gioguedes/sistema-tcc-completo/hardware/caixa/render/base.png

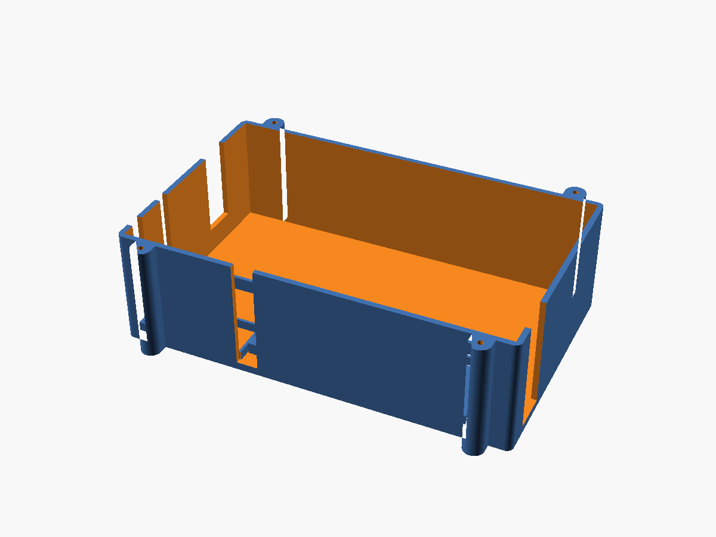
hardware/caixa/render/base.png
