gioguedes/sistema-tcc-completo/hardware/caixa/render/base_frente.png

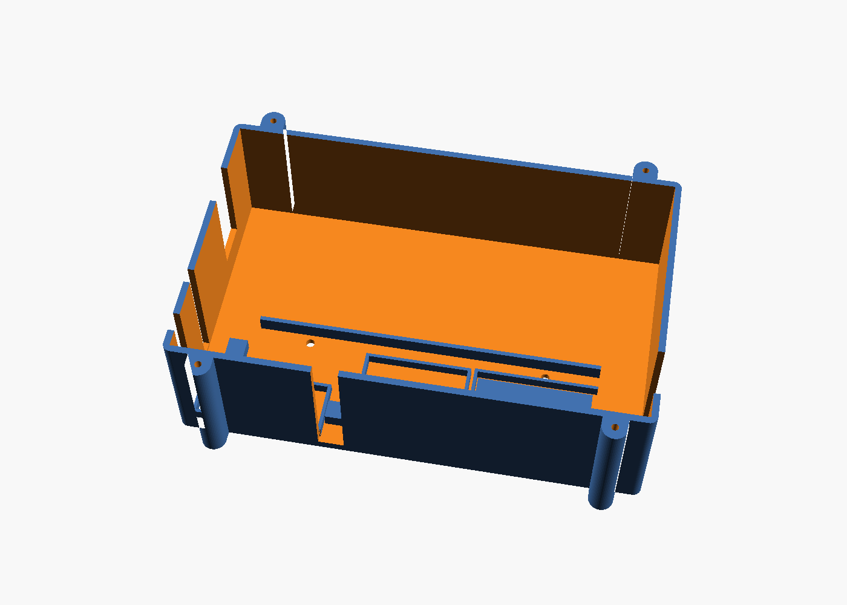
hardware/caixa/render/base_frente.png
