gioguedes/sistema-tcc-completo/hardware/caixa/render/gancho.png

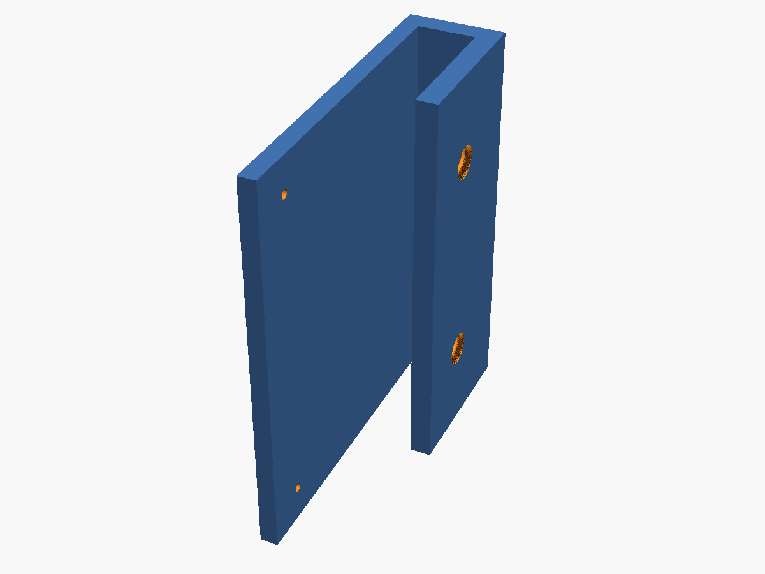
hardware/caixa/render/gancho.png
