gioguedes/sistema-tcc-completo/hardware/caixa/render/mesa_0-provas-opcional.png

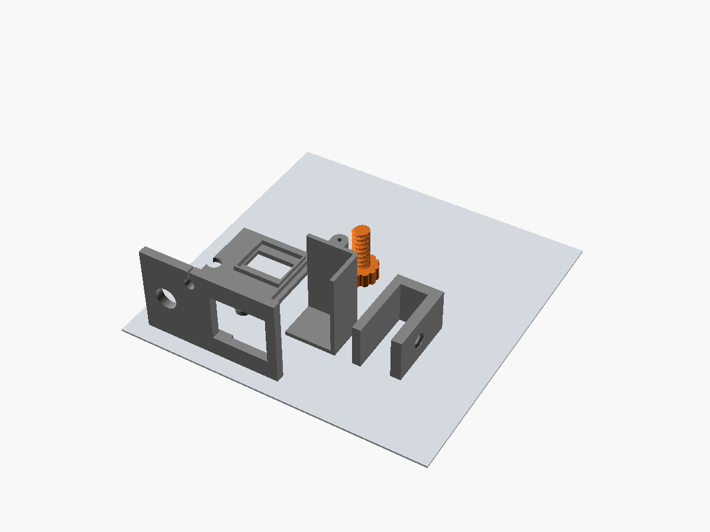
hardware/caixa/render/mesa_0-provas-opcional.png
