gioguedes/sistema-tcc-completo/hardware/caixa/render/mesa_1-base-e-parafusos.png

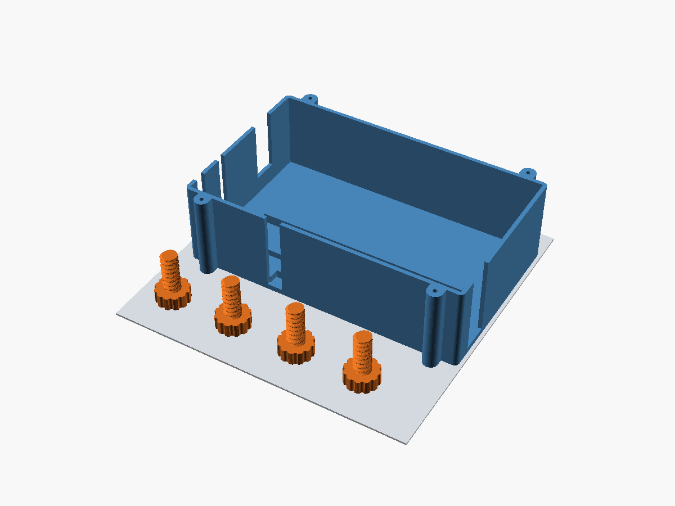
hardware/caixa/render/mesa_1-base-e-parafusos.png
