gioguedes/sistema-tcc-completo/hardware/caixa/render/mesa_2-gancho-e-suporte.png

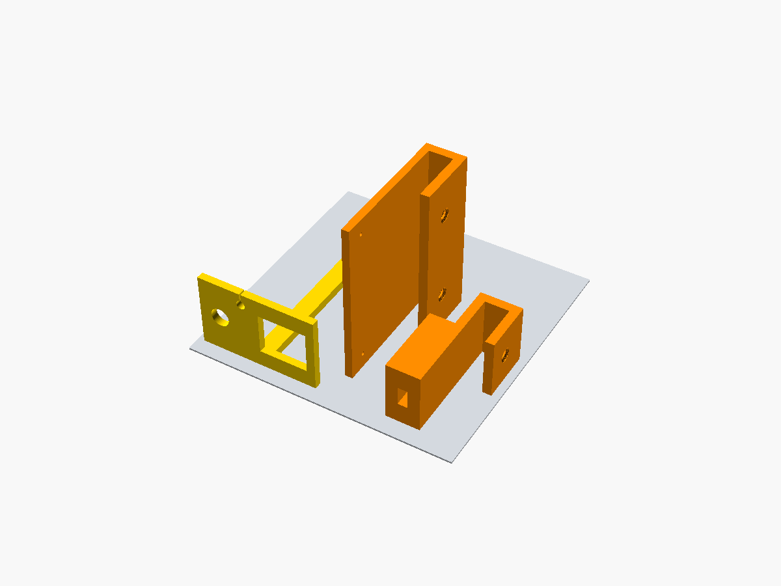
hardware/caixa/render/mesa_2-gancho-e-suporte.png
