gioguedes/sistema-tcc-completo/hardware/caixa/render/mesa_3-tampa.png

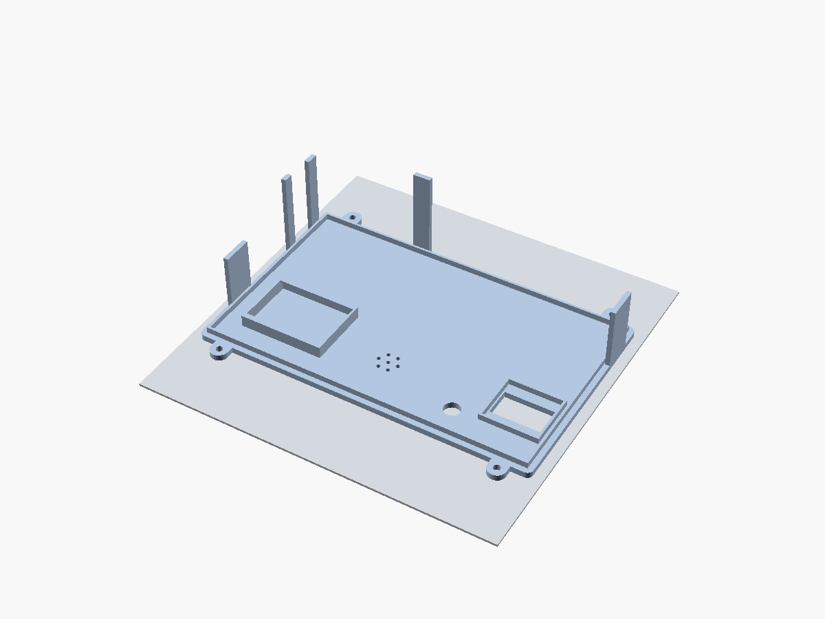
hardware/caixa/render/mesa_3-tampa.png
