gioguedes/sistema-tcc-completo/hardware/caixa/render/parafuso.png

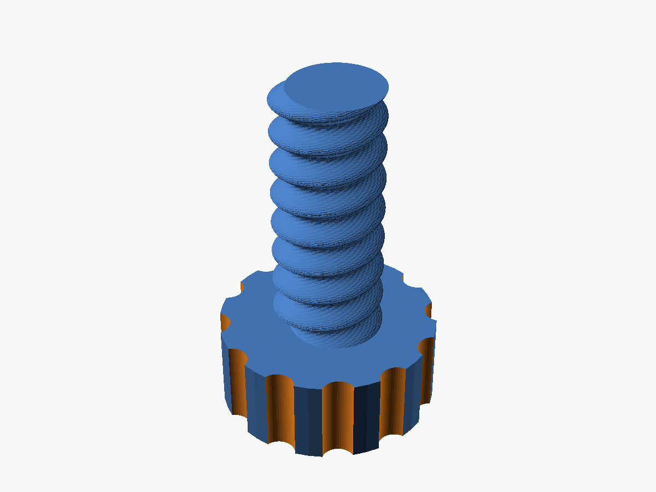
hardware/caixa/render/parafuso.png
