gioguedes/sistema-tcc-completo/hardware/caixa/render/prova_base.png

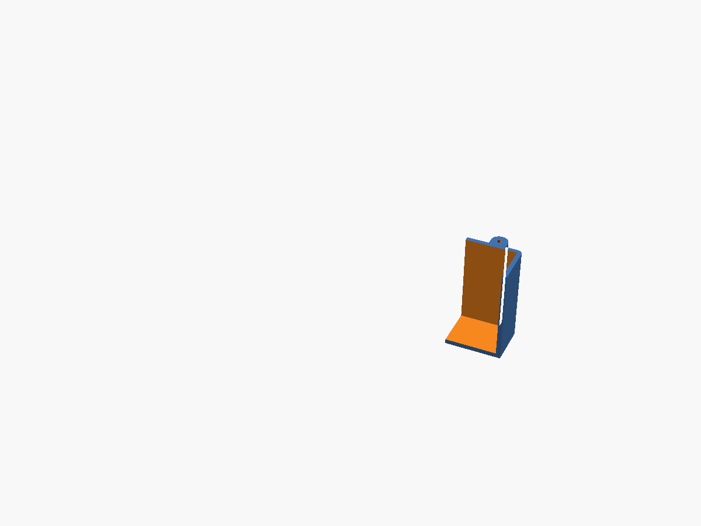
hardware/caixa/render/prova_base.png
