gioguedes/sistema-tcc-completo/hardware/caixa/render/prova_gancho.png

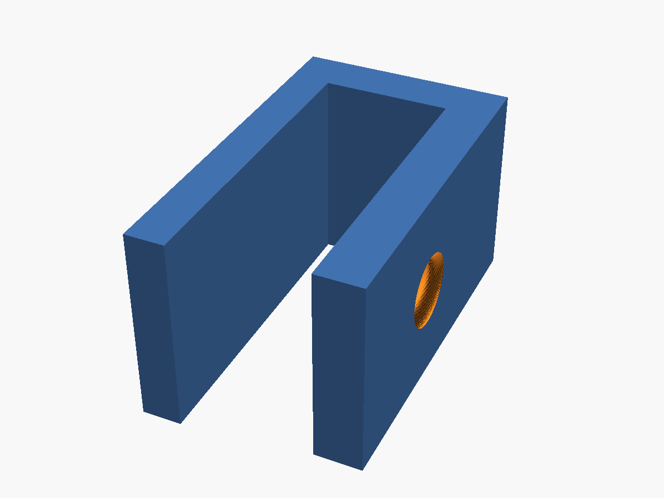
hardware/caixa/render/prova_gancho.png
