gioguedes/sistema-tcc-completo/hardware/caixa/render/prova_suporte.png

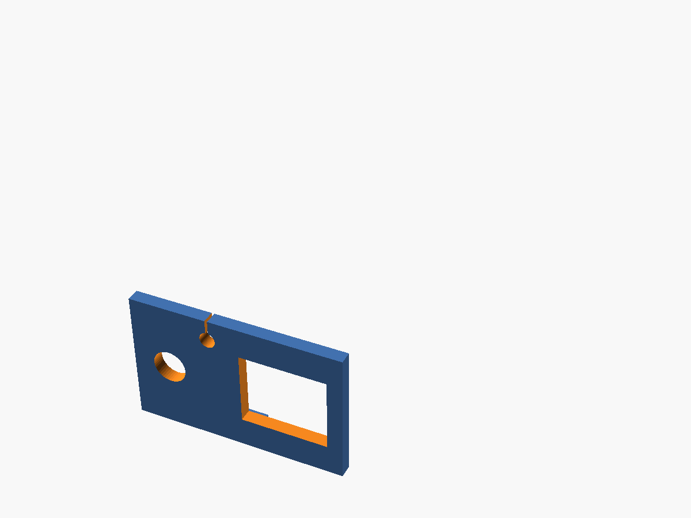
hardware/caixa/render/prova_suporte.png
