gioguedes/sistema-tcc-completo/hardware/caixa/render/prova_tampa.png

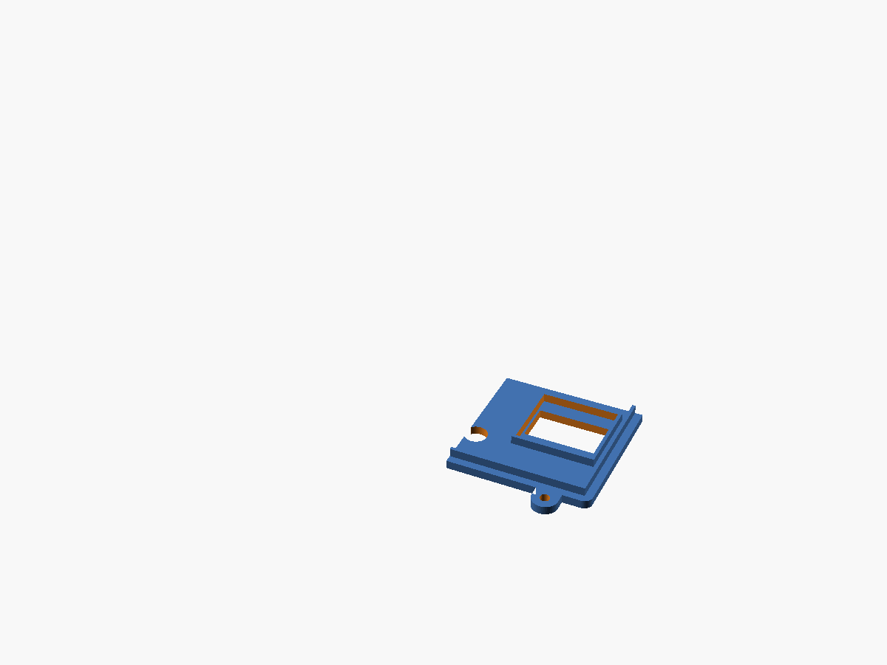
hardware/caixa/render/prova_tampa.png
