gioguedes/sistema-tcc-completo/hardware/caixa/render/suporte_braco.png

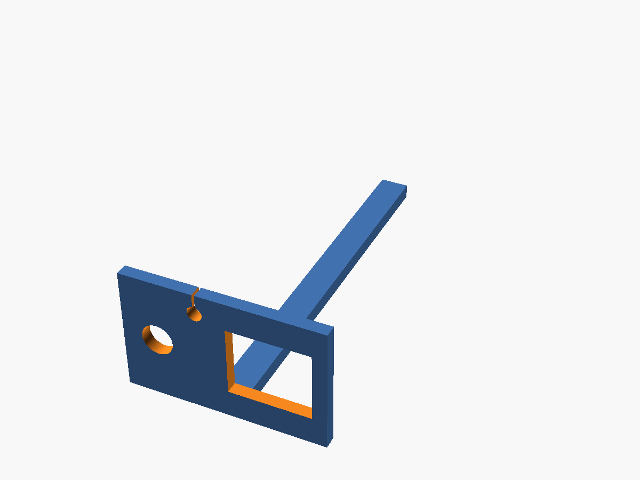
hardware/caixa/render/suporte_braco.png
