gioguedes/sistema-tcc-completo/hardware/caixa/render/suporte_presilha.png

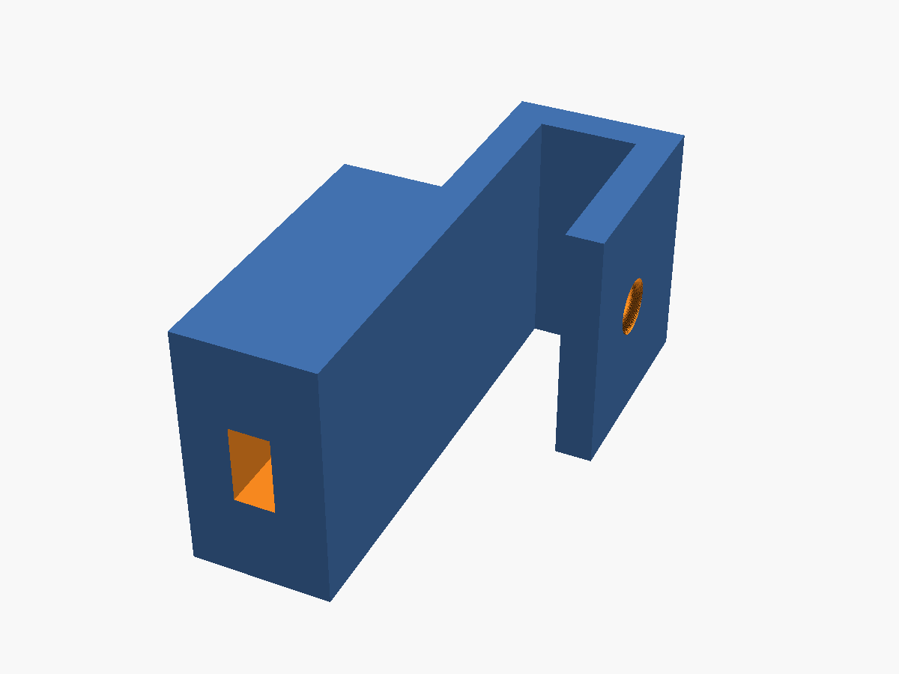
hardware/caixa/render/suporte_presilha.png
