gioguedes/sistema-tcc-completo/hardware/caixa/render/tampa.png

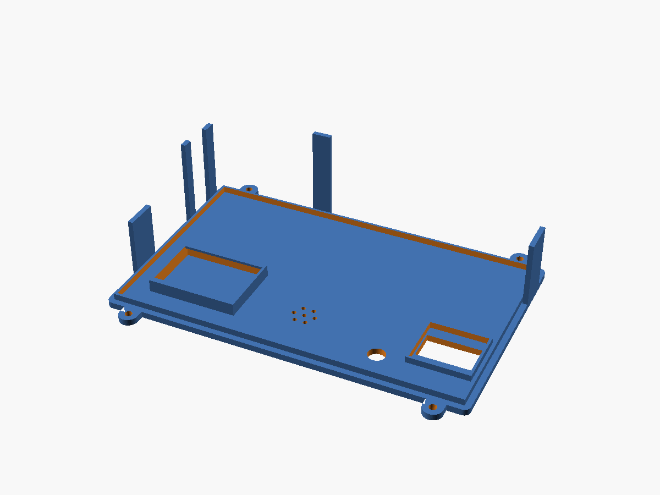
hardware/caixa/render/tampa.png
