gioguedes/sistema-tcc-completo/hardware/caixa/mesas/3-tampa.stl

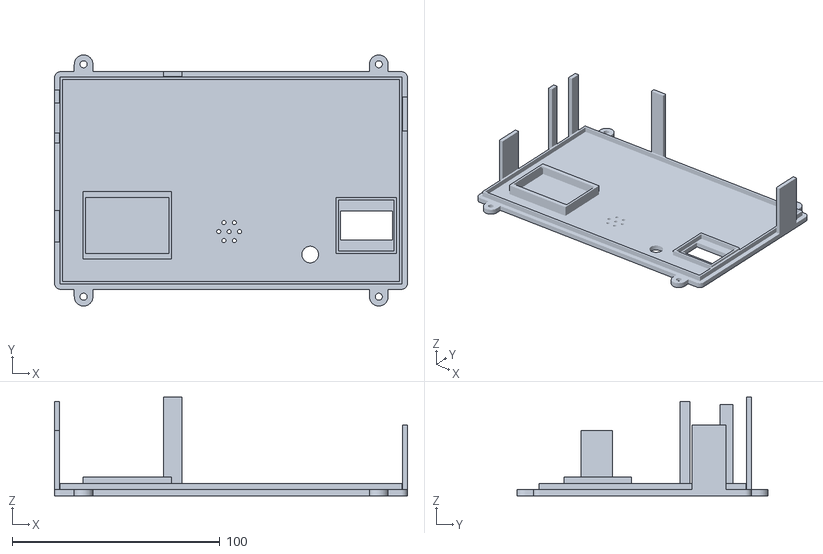
[picture p17: CAD file, 2026-11-05]
hardware/caixa/mesas/3-tampa.stl
169.8 x 120.8 x 47.5
