gioguedes/sistema-tcc-completo/hardware/caixa/stl/suporte_presilha.stl

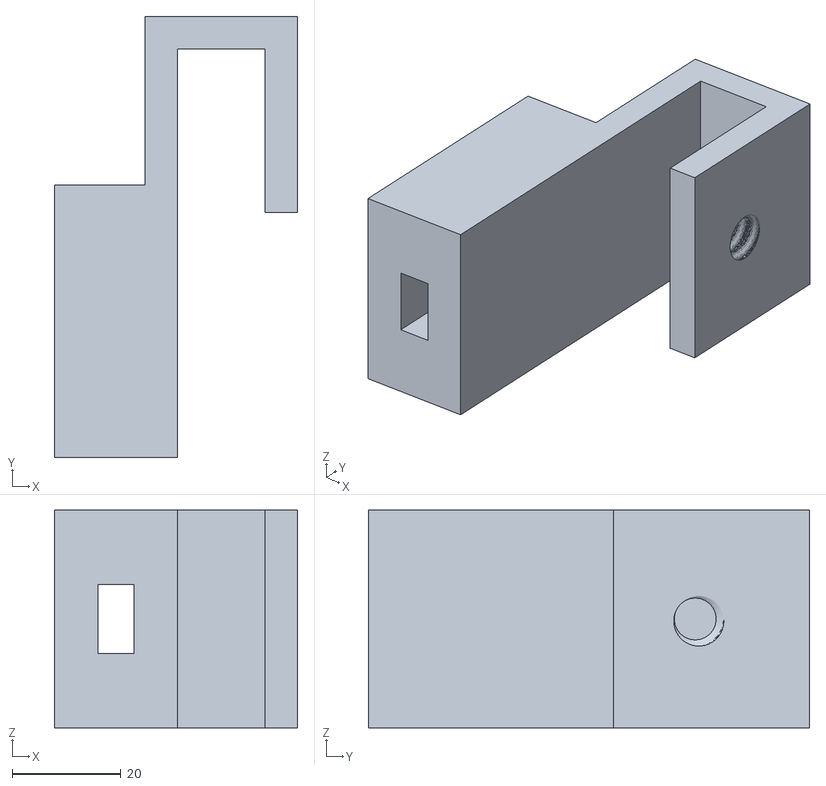
[picture p18: CAD file, 2026-11-05]
hardware/caixa/stl/suporte_presilha.stl
44.6 x 81.0 x 40.0
