gioguedes/sistema-tcc-completo/hardware/caixa/mesas/0-provas-opcional.stl

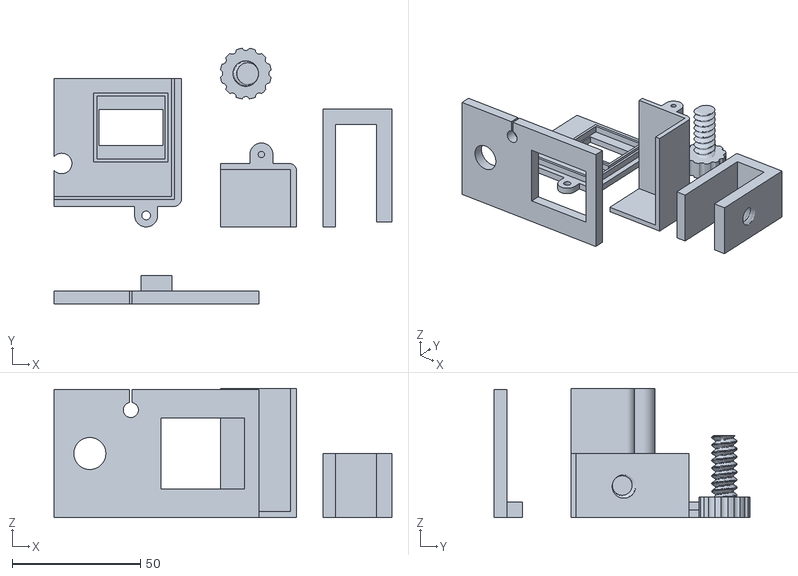
[picture p19: CAD file, 2026-11-05]
hardware/caixa/mesas/0-provas-opcional.stl
132.0 x 99.8 x 50.4
