gioguedes/sistema-tcc-completo/hardware/caixa/stl/tampa.stl

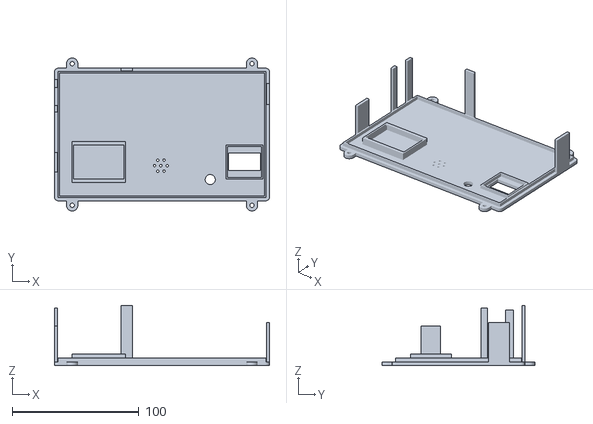
[picture p20: CAD file, 2026-11-05]
hardware/caixa/stl/tampa.stl
169.8 x 120.8 x 47.5
