gioguedes/sistema-tcc-completo/hardware/caixa/mesas/1-base-e-parafusos.stl

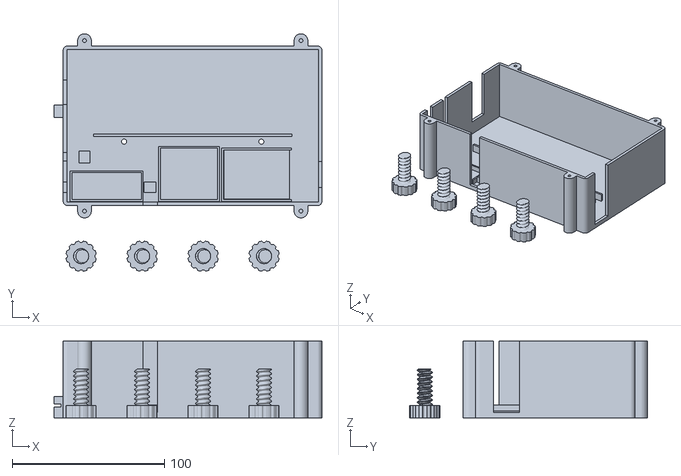
[picture p21: CAD file, 2026-11-05]
hardware/caixa/mesas/1-base-e-parafusos.stl
175.8 x 155.8 x 50.4
