gioguedes/sistema-tcc-completo/hardware/caixa/stl/suporte_braco.stl

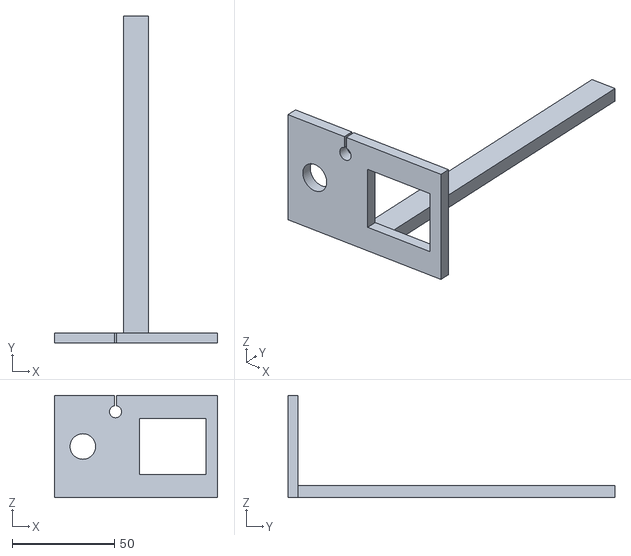
[picture p22: CAD file, 2026-11-05]
hardware/caixa/stl/suporte_braco.stl
80.0 x 160.0 x 50.0
