gioguedes/sistema-tcc-completo/hardware/caixa/mesas/2-gancho-e-suporte.stl

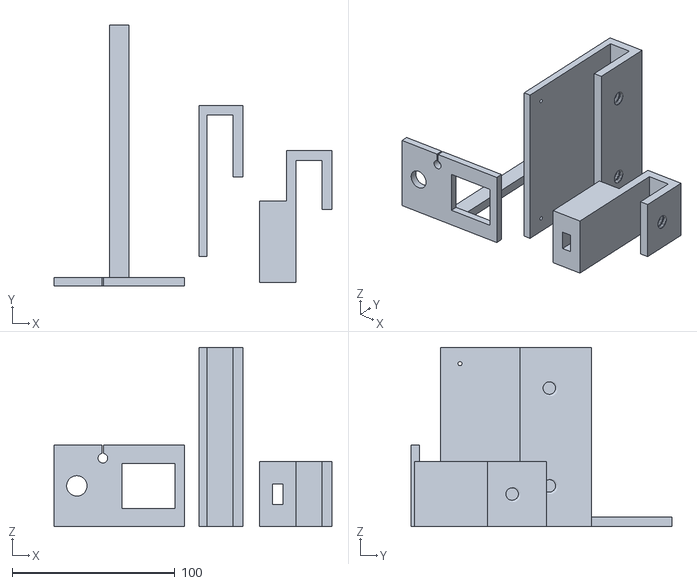
[picture p23: CAD file, 2026-11-05]
hardware/caixa/mesas/2-gancho-e-suporte.stl
170.6 x 160.0 x 110.0
