gioguedes/sistema-tcc-completo/hardware/caixa/stl/gancho.stl

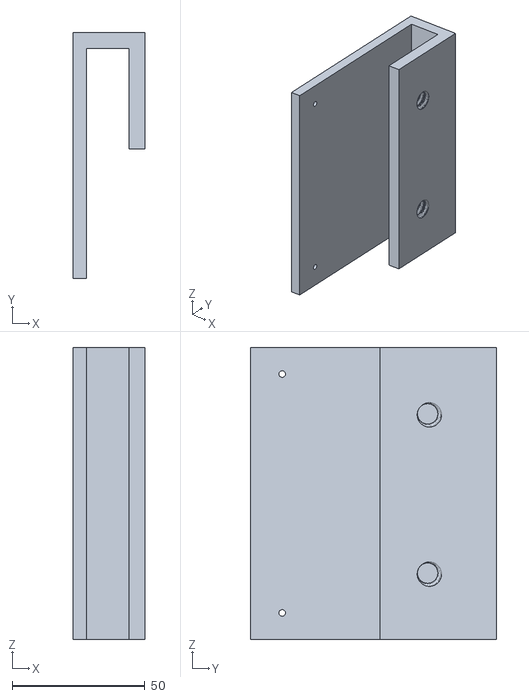
[picture p24: CAD file, 2026-11-05]
hardware/caixa/stl/gancho.stl
27.0 x 92.8 x 110.0
