gioguedes/sistema-tcc-completo/hardware/caixa/stl/prova_gancho.stl

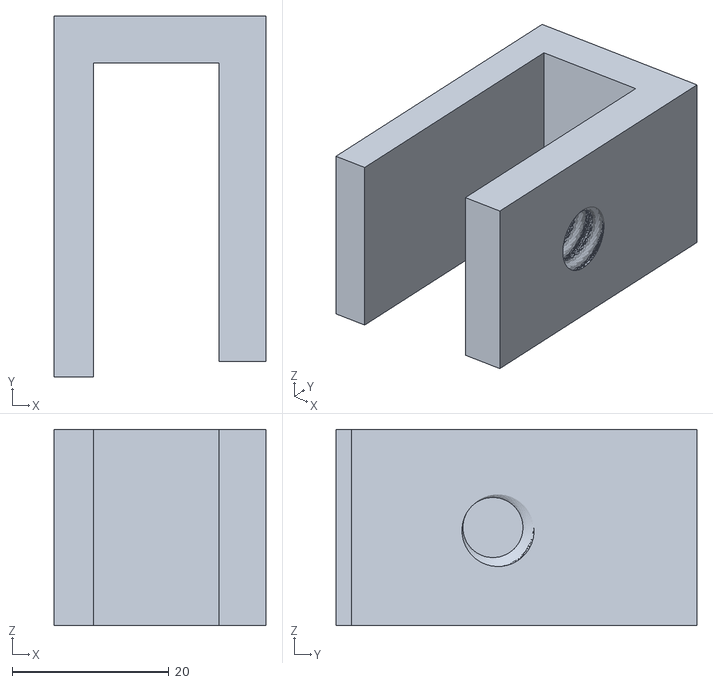
[picture p25: CAD file, 2026-11-05]
hardware/caixa/stl/prova_gancho.stl
27.0 x 46.0 x 25.0
