gioguedes/sistema-tcc-completo/hardware/caixa/stl/prova_suporte.stl

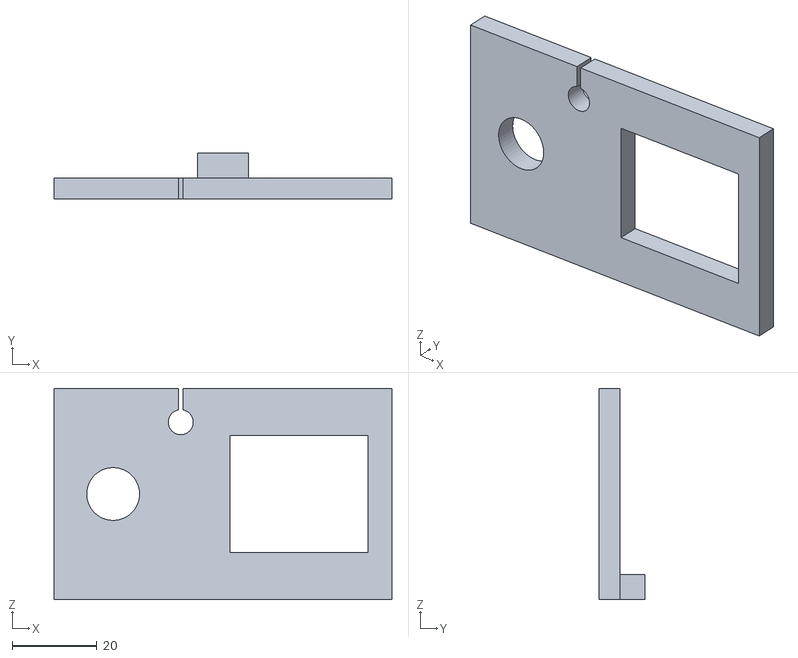
[picture p26: CAD file, 2026-11-05]
hardware/caixa/stl/prova_suporte.stl
80.0 x 11.0 x 50.0
