gioguedes/sistema-tcc-completo/hardware/caixa/stl/parafuso.stl

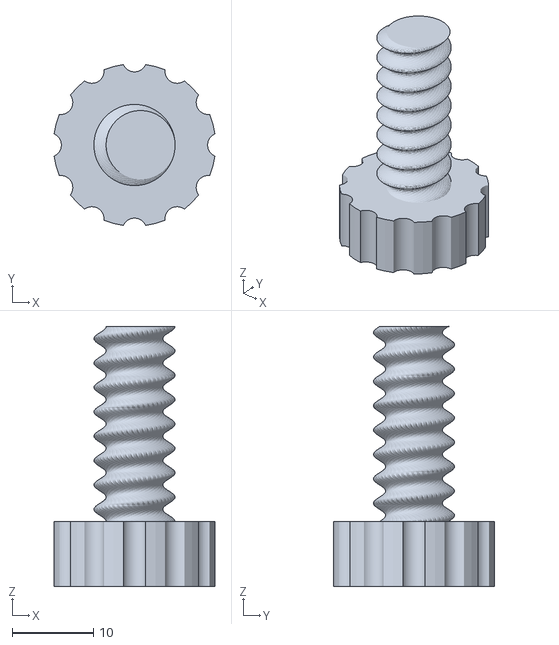
[picture p27: CAD file, 2026-11-05]
hardware/caixa/stl/parafuso.stl
19.8 x 19.8 x 32.0
