gioguedes/sistema-tcc-completo/hardware/caixa/stl/prova_base.stl

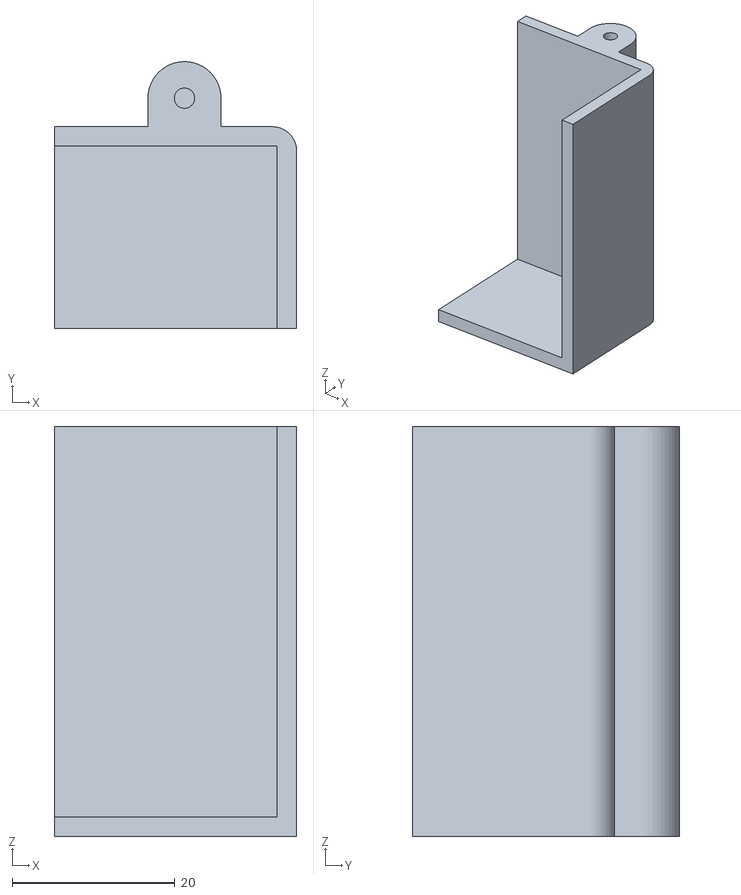
[picture p28: CAD file, 2026-11-05]
hardware/caixa/stl/prova_base.stl
29.8 x 32.8 x 50.4
