gioguedes/sistema-tcc-completo/hardware/caixa/stl/prova_tampa.stl

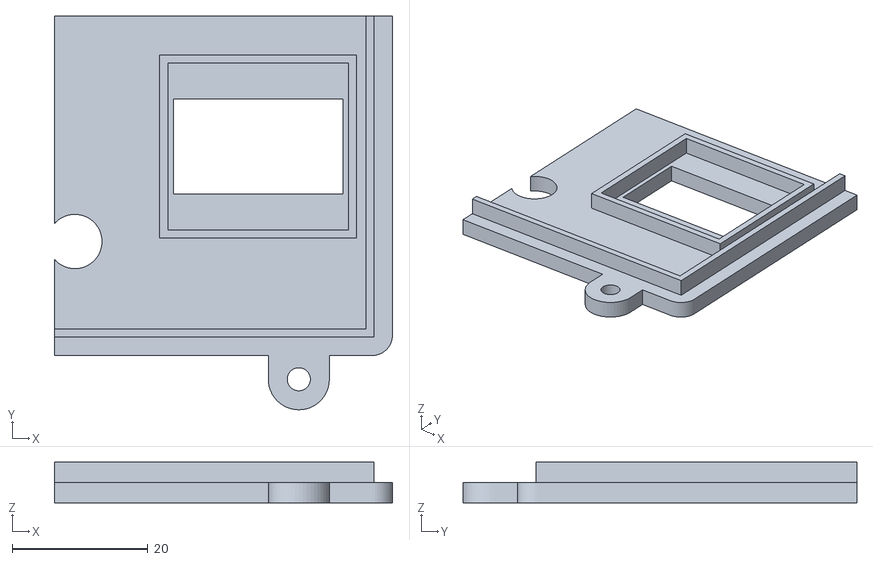
[picture p29: CAD file, 2026-11-05]
hardware/caixa/stl/prova_tampa.stl
49.8 x 58.0 x 6.00
