gioguedes/sistema-tcc-completo/hardware/caixa/stl/base.stl

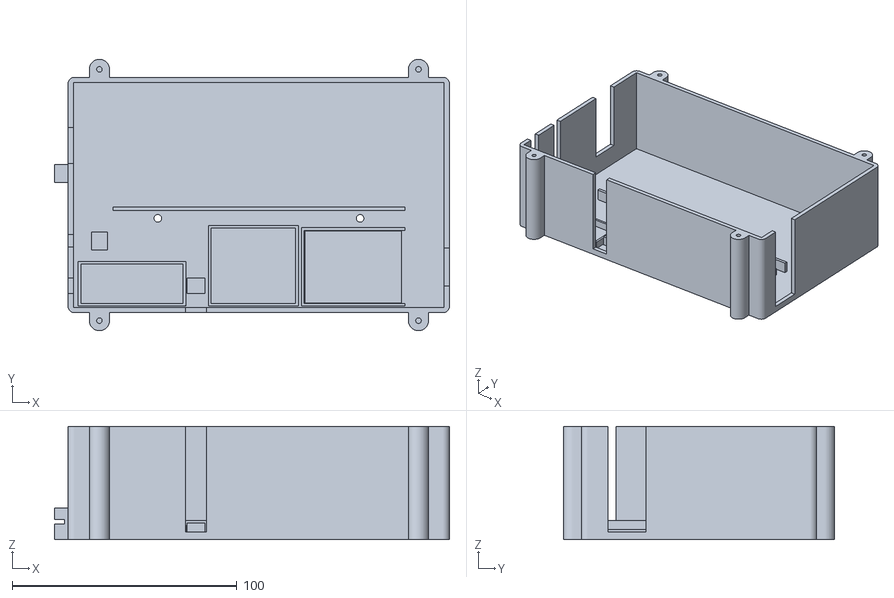
[picture p30: CAD file, 2026-11-05]
hardware/caixa/stl/base.stl
175.8 x 120.8 x 50.4
