gioguedes/sistema-tcc-completo/hardware/caixa/render/montagem_tras.png

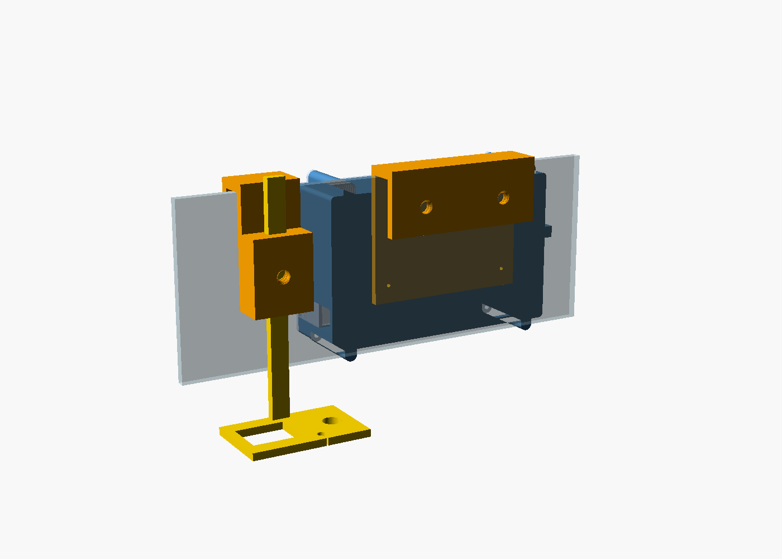
hardware/caixa/render/montagem_tras.png
