gioguedes/sistema-tcc-completo/(commit log)

2026-09-22 adiciona teste de Settings (config)
2026-09-22 implementa Settings para leitura de variaveis de ambiente
2026-09-22 adiciona sessao de banco (engine e sessionmaker)
2026-09-23 adiciona unique constraint para dedup de leituras
2026-09-23 adiciona servico mosquitto isolado para testes
2026-09-23 adiciona teste de fumaca do broker de teste
2026-09-23 adiciona fixtures de banco de teste isolado (piscicultura_test)
2026-09-24 adiciona teste do script de seed
2026-09-24 implementa script de seed para usuario, tanque, dispositivo e sensores
2026-09-24 implementa validacao do payload mqtt do no sensor
2026-09-24 adiciona testes do processor de ingestao
2026-09-24 adiciona entrypoint do backend de ingestao
2026-10-15 adiciona testes do modelo de previsoes
2026-10-15 modela a tabela previsoes com horizonte 0 para o od atual
2026-10-15 adiciona migracao que libera horizonte 0 em previsoes
2026-10-15 adiciona dependencias do servico de ml
2026-10-15 adiciona exemplo de variaveis de ambiente do ml
2026-10-15 adiciona teste de Settings do ml
2026-10-15 implementa Settings do ml para leitura do .env
2026-10-15 adiciona testes de fronteira da classificacao por faixa (CT05)
2026-10-15 adiciona testes da carga dos rdb e das regras de limpeza
2026-10-15 implementa carga dos rdb do USGS com conversao do fuso local para utc
2026-10-15 implementa regras de limpeza com contagem por regra
2026-10-16 adiciona testes da grade de 15 minutos e das variaveis de janela
2026-10-16 implementa grade de 15 minutos, variaveis de janela e cobertura compartilhadas
2026-10-16 implementa serie de 15 minutos por ponto do USGS
2026-10-16 implementa rotulo do nivel real no bloco de t+h
2026-10-16 adiciona testes do estimador de od
2026-10-16 implementa estimador de od com xgboost, quantis e linhas de base
2026-10-16 adiciona gerador de dados sinteticos e testes do classificador de risco
2026-10-16 implementa classificador de risco por horizonte com persistencia como base
2026-10-16 implementa pacote unico de modelos com metadados
2026-10-16 adiciona testes do relatorio, dos vereditos de H1 e H2 e do treino
2026-10-16 implementa relatorio de treino com validacao cruzada, split temporal e vereditos
2026-10-16 implementa comando de treino ponta a ponta
2026-10-17 adiciona banco de teste do ml montado com o ddl e as migracoes reais
2026-10-17 adiciona testes da leitura da janela em blocos de 15 minutos
2026-10-17 implementa leitura de tanques ativos e da janela de 90 minutos em blocos
2026-10-17 adiciona testes do ciclo do servico de previsao
2026-10-17 implementa inferencia de od e risco sobre os blocos de 15 minutos do tanque
2026-10-17 implementa loop periodico do servico de ml
2026-10-17 adiciona testes do importador de od manual
2026-10-17 implementa importador de medicoes manuais de od
2026-10-17 adiciona teste do simulador de leituras
2026-10-17 adiciona simulador de leituras mqtt com ts retroativo
2026-10-26 adiciona o painel web (dashboard) vindo do front-end-tcc, com menu recolhivel, inicio reorganizado e sem avisos de WhatsApp e niveis de acesso
2026-10-30 impede que um erro de gravacao ou payload fora do dominio derrube a ingestao
2026-10-30 mostra o % de saturacao do od corrigido pela altitude e avisa od baixo com agua quente
2026-10-30 adiciona aerador automatico com histerese no servico de ml
2026-10-30 preve o risco prevendo ph e temperatura e aplicando a regra de faixas, estima o od pela saturacao com correcao de altitude e zera a confianca fora do dominio
2026-10-30 publica o banco e o broker de teste so em localhost e exige a senha do banco no env
2026-11-05 permite client id proprio na ingestao para rodar em outra maquina
2026-11-05 adiciona modo demonstracao ao servico de ml para acompanhar a troca de copo
2026-11-05 adiciona firmware do no sensor, caixa 3d e evidencias de bancada
2026-11-05 adiciona scripts de demonstracao e de ensaio
2026-11-05 adiciona servico de alertas que dispara webhook do n8n quando o estado do tanque muda
2026-11-05 permite configurar no painel o webhook do n8n para os alertas
2026-11-10 descarta na ingestao leitura datada mais de 10 minutos a frente do relogio
2026-11-10 chama de estimativa do modelo a serie do od na legenda dos graficos
2026-11-10 adiciona medidas complementares dos modelos: linhas de base fisicas do od, od baixo, confianca e avisos antecipados
2026-11-10 baixa o limiar de baixa confianca do od de 0,5 para 0,33, o quartil inferior medido entre corpos d'agua
2026-11-10 atualiza o readme com as medidas complementares, o descarte de leitura futura e a contagem de testes
2026-11-10 documenta o arduino-cli avulso do notebook, com as versoes do nucleo e das bibliotecas
2026-11-10 exige duas leituras criticas seguidas de ph ou temperatura para abrir o alerta
2026-11-11 so encerra o alerta critico depois de cinco leituras seguidas sem leitura critica
2026-11-11 sobe o servico de alertas junto com os demais no script da demonstracao
2026-11-11 fixa fim de linha lf nos scripts de shell, que rodam no bash do git
2026-11-11 lista na api os alertas gravados, com nivel, parametro e recomendacao guardados pelo servico de alertas
2026-11-11 mostra no painel o aviso de fim da condicao critica com titulo proprio e tira o tempo da etiqueta de envio
2026-11-11 mostra no log o codigo http quando o webhook de alertas recusa o envio
